Aifryz/sensor-hub/hardware/sensor-hub/v1.0/sensor-hub.pdf

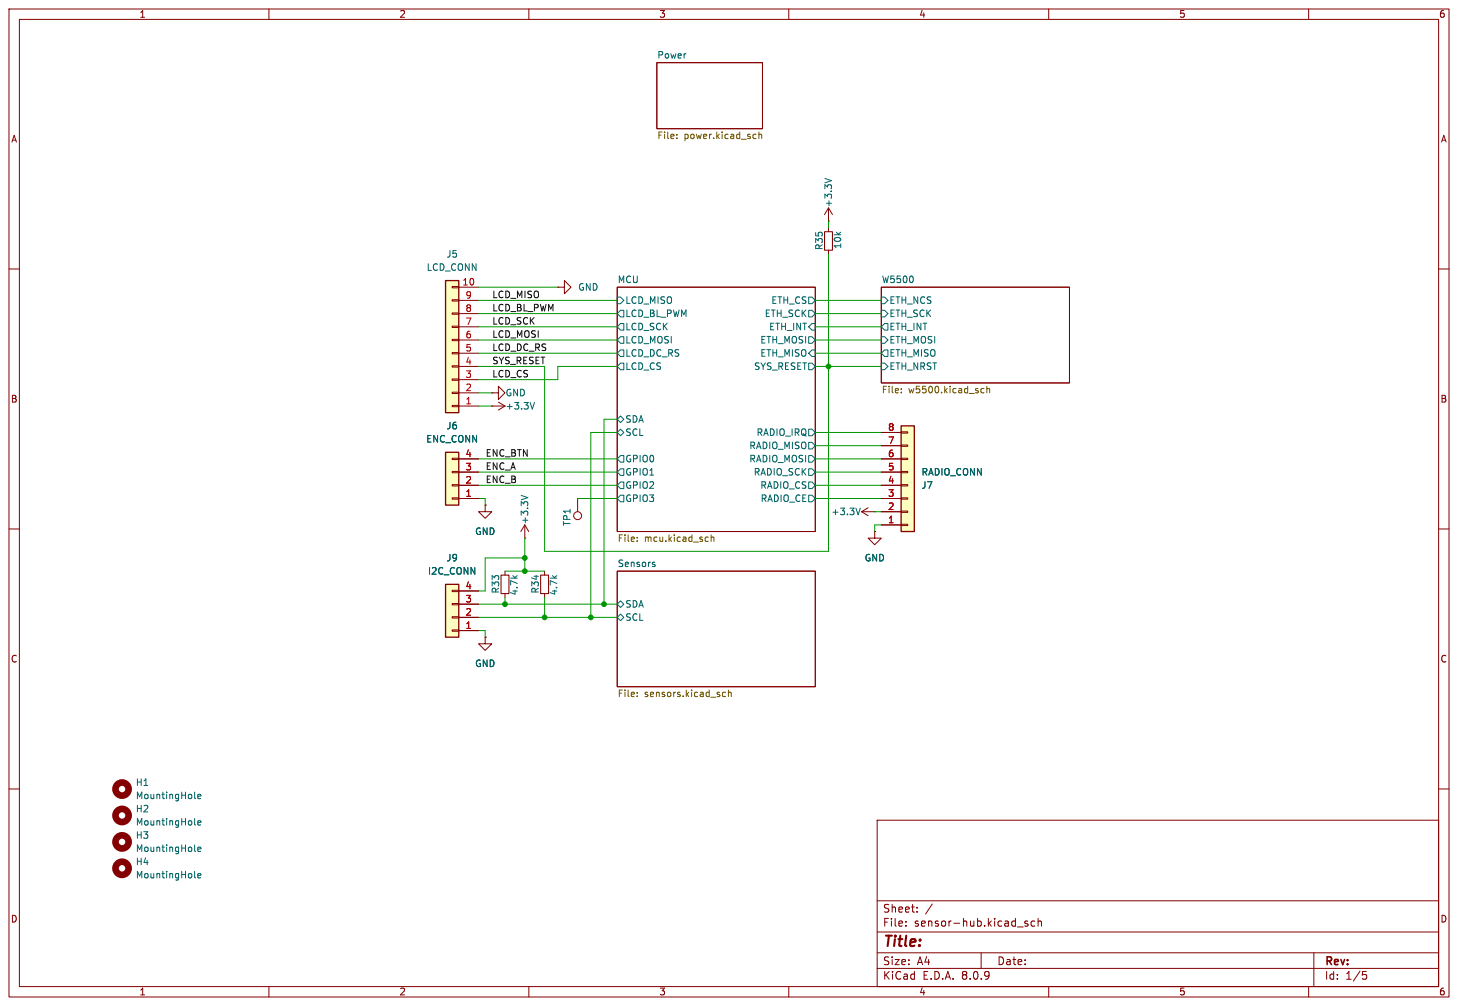
[picture p1: page 1]

Id: 1/5 Title: File: sensor-hub.kicad_sch Sheet: /

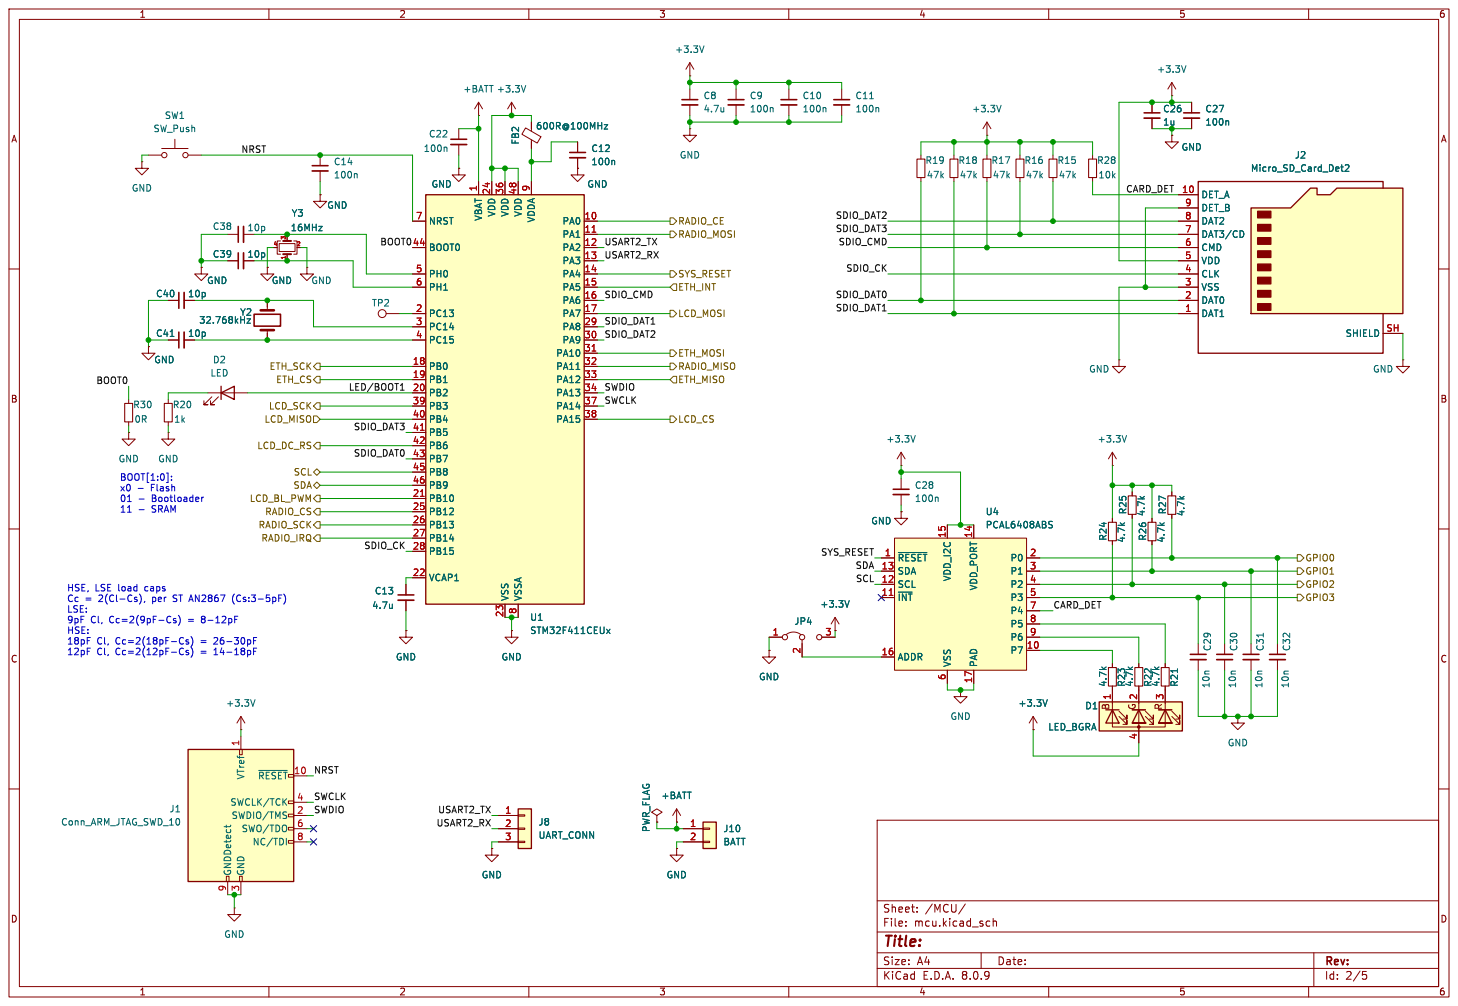
[picture p2: page 2]

1 PA0 10 PA1 11 PA2 12 PA3 13 PA4 14 PA5 15 PA6 16 PA7 17 PB0 18 PB1 19 PC13 2 PB2 20 PB10 21 VCAP1 22 VSS 23 VDD 24 PB12 25 PB13 26 PB14 27 PB15 28 PA8 29 PC14 3 PA9 30 PA10 31 PA11 32 PA12 33 PA13 34 VDD 36 PA14 37 PA15 38 PB3 39 PC15 4 PB4 40 PB5 41 PB6 42 PB7 43 BOOT0 44 PB8 45 PB9 46 VDD 48 PH0 5 PH1 6 NRST 7 VSSA

3 SWCLK/TCK 4 SWO/TDO 6 NC/TDI 8 GNDDetect 9

Id: 2/5 Title: File: mcu.kicad_sch Sheet: /MCU/

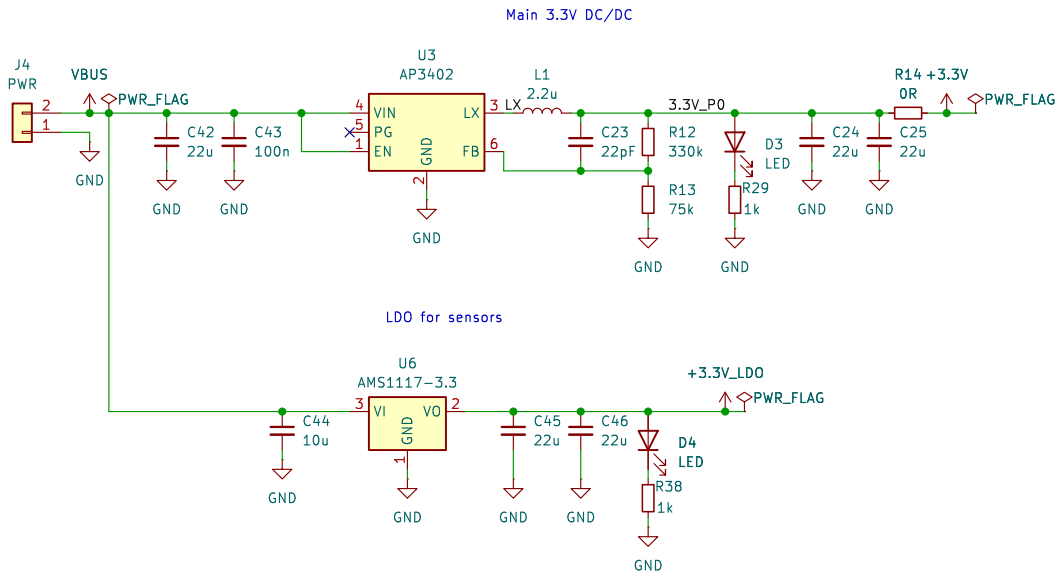
[picture p3: page 3]

LDO for sensors Main 3.3V DC/DC

Id: 3/5 Title: File: power.kicad_sch Sheet: /Power/

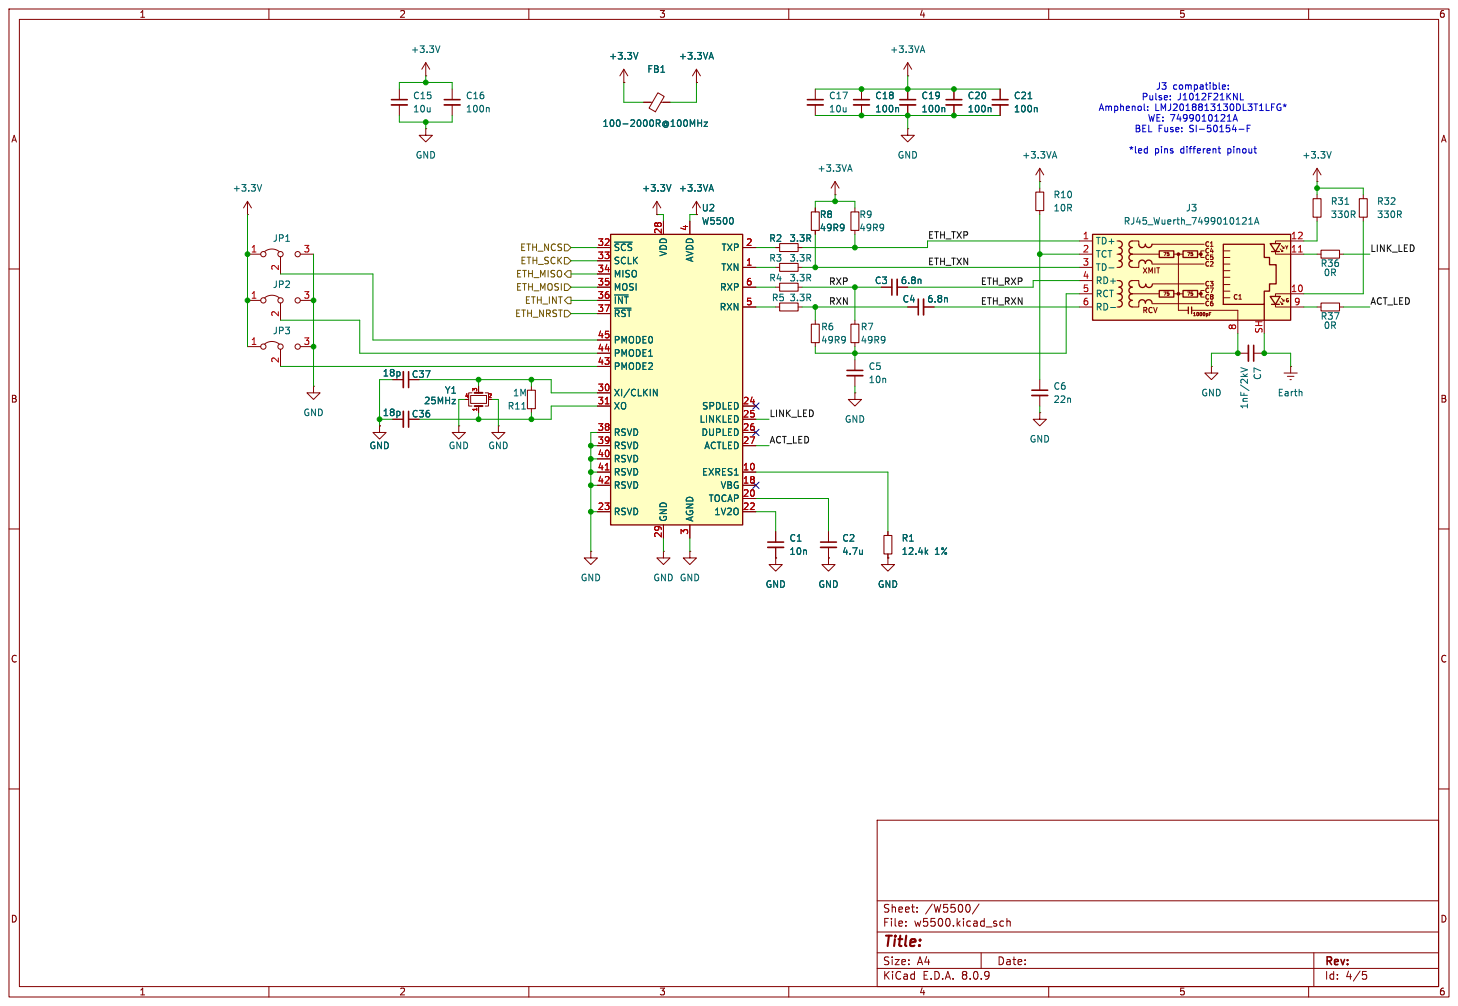
[picture p4: page 4]

J3 compatible: Pulse: J1012F21KNL Amphenol: LMJ2018813130DL3T1LFG* WE: 7499010121A

4 RSVD 40 RSVD 41 RSVD 42 PMODE2 43 PMODE1 44 PMODE0 45 RXN 5 RXP 6 U2 W5500 GND GND GND

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

3 XI/CLKIN 30 XO 31 ~{SCS} 32 SCLK 33 MISO 34 MOSI 35 ~{INT} 36 ~{RST} 37 RSVD 38 RSVD 39 AVDD

Id: 4/5 Title: File: w5500.kicad_sch Sheet: /W5500/

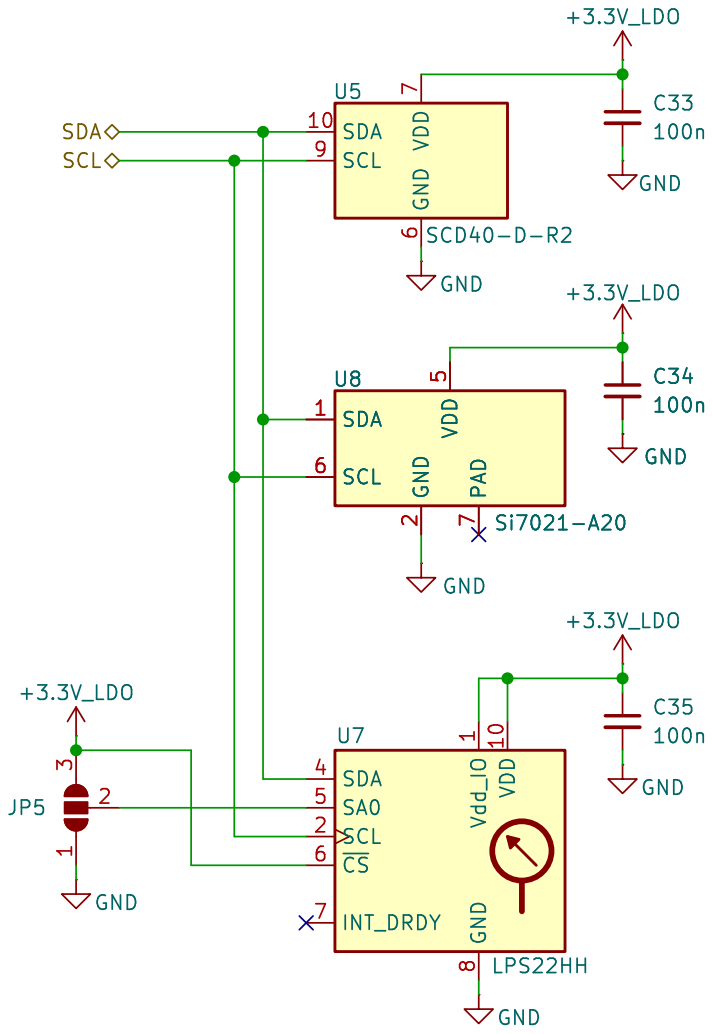
[picture p5: page 5]

Id: 5/5 Title: File: sensors.kicad_sch Sheet: /Sensors/
