Aifryz/sensor-hub/hardware/sensor-hub/sensor-hub.kicad_pcb

## KiCad design hardware/sensor-hub/sensor-hub.kicad_pcb (2025-05-18)

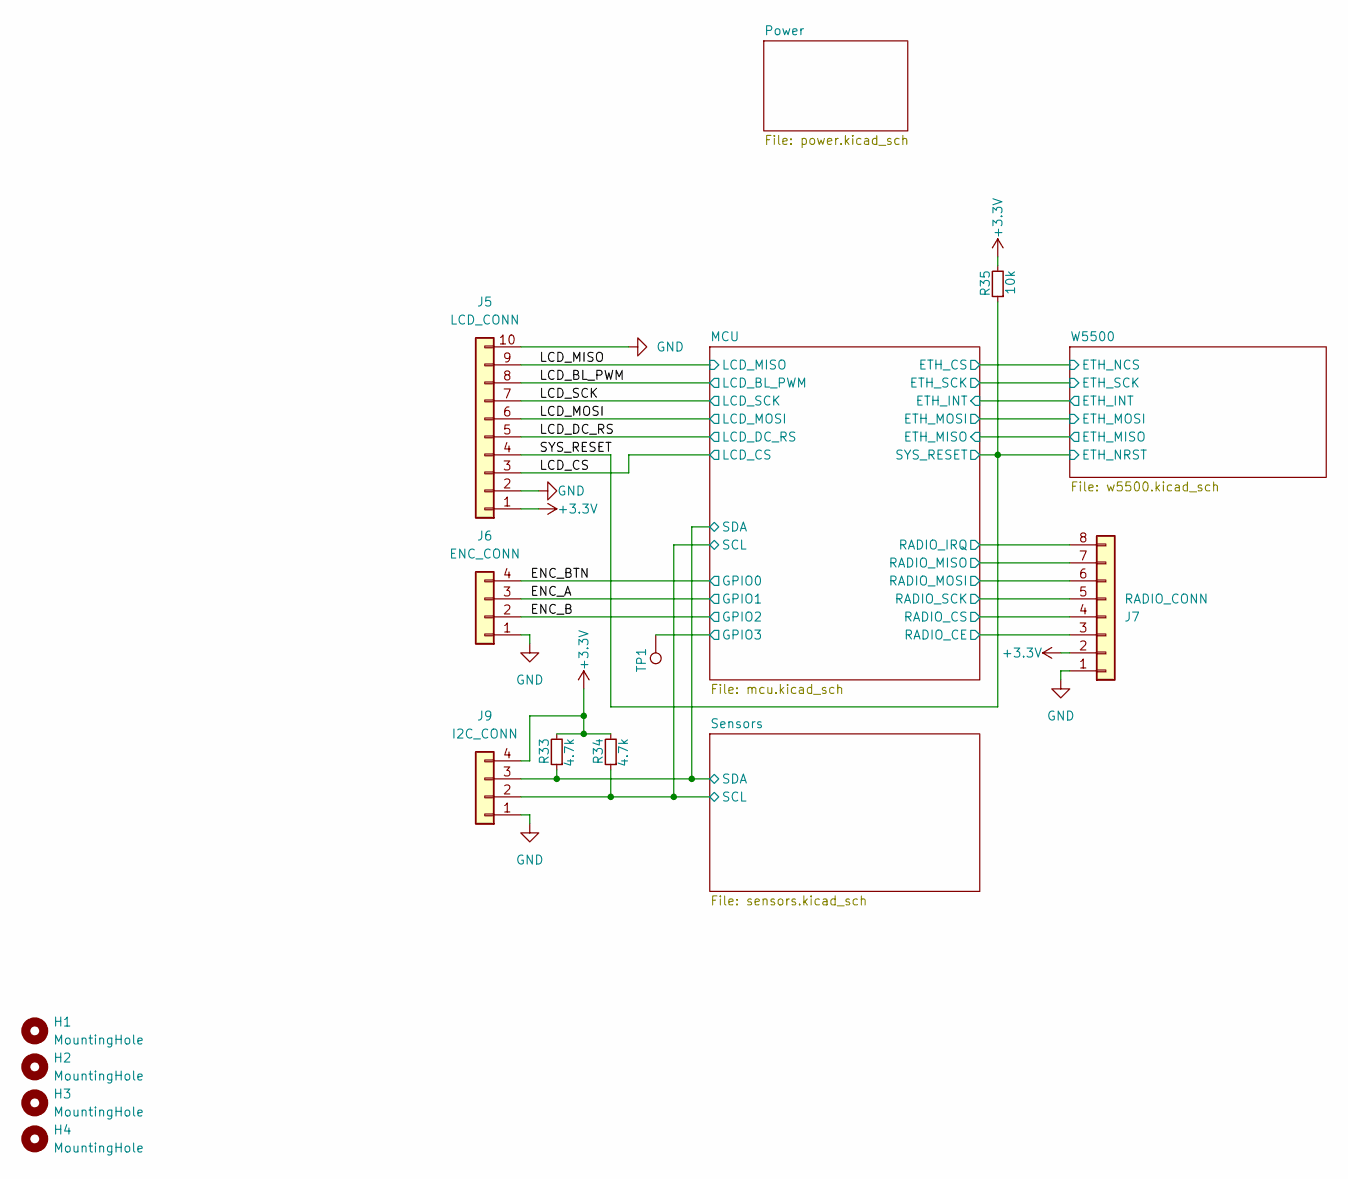
[picture p6: schematic sensor-hub.kicad_sch]

Parts:
H1, H2, H3, H4: MountingHole; MountingHole_3mm
J5: LCD_CONN; TE_Micro-MaTch_1-215079-0_2x05_P1.27mm_Vertical
J6: ENC_CONN; TE_Micro-MaTch_215079-4_2x02_P1.27mm_Vertical
J7: RADIO_CONN; TE_Micro-MaTch_215079-8_2x04_P1.27mm_Vertical
J9: I2C_CONN; PinHeader_1x04_P2.54mm_Vertical
R33, R34: 4.7k; R_0603_1608Metric
R35: 10k; R_0603_1608Metric
TP1: TestPoint; TestPoint_Pad_D1.0mm

Connections:
+3.3V: J5.1, J7.2, J9.4, R33.2, R34.2, R35.2; also elsewhere on the board
/ENC_A: J6.3; also elsewhere on the board
/ENC_B: J6.2; also elsewhere on the board
/ENC_BTN: J6.4; also elsewhere on the board
/LCD_BL_PWM: J5.8; also elsewhere on the board
/LCD_CS: J5.3; also elsewhere on the board
/LCD_DC_RS: J5.5; also elsewhere on the board
/LCD_MISO: J5.9; also elsewhere on the board
/LCD_MOSI: J5.6; also elsewhere on the board
/LCD_SCK: J5.7; also elsewhere on the board
/MCU/GPIO3: TP1.1; also elsewhere on the board
/MCU/RADIO_CE: J7.3; also elsewhere on the board
/MCU/RADIO_CS: J7.4; also elsewhere on the board
/MCU/RADIO_IRQ: J7.8; also elsewhere on the board
/MCU/RADIO_MISO: J7.7; also elsewhere on the board
/MCU/RADIO_MOSI: J7.6; also elsewhere on the board
/MCU/RADIO_SCK: J7.5; also elsewhere on the board
/MCU/SCL: J9.2, R34.1; also elsewhere on the board
/MCU/SDA: J9.3, R33.1; also elsewhere on the board
/SYS_RESET: J5.4, R35.1; also elsewhere on the board
GND: J5.2, J5.10, J6.1, J7.1, J9.1; also elsewhere on the board

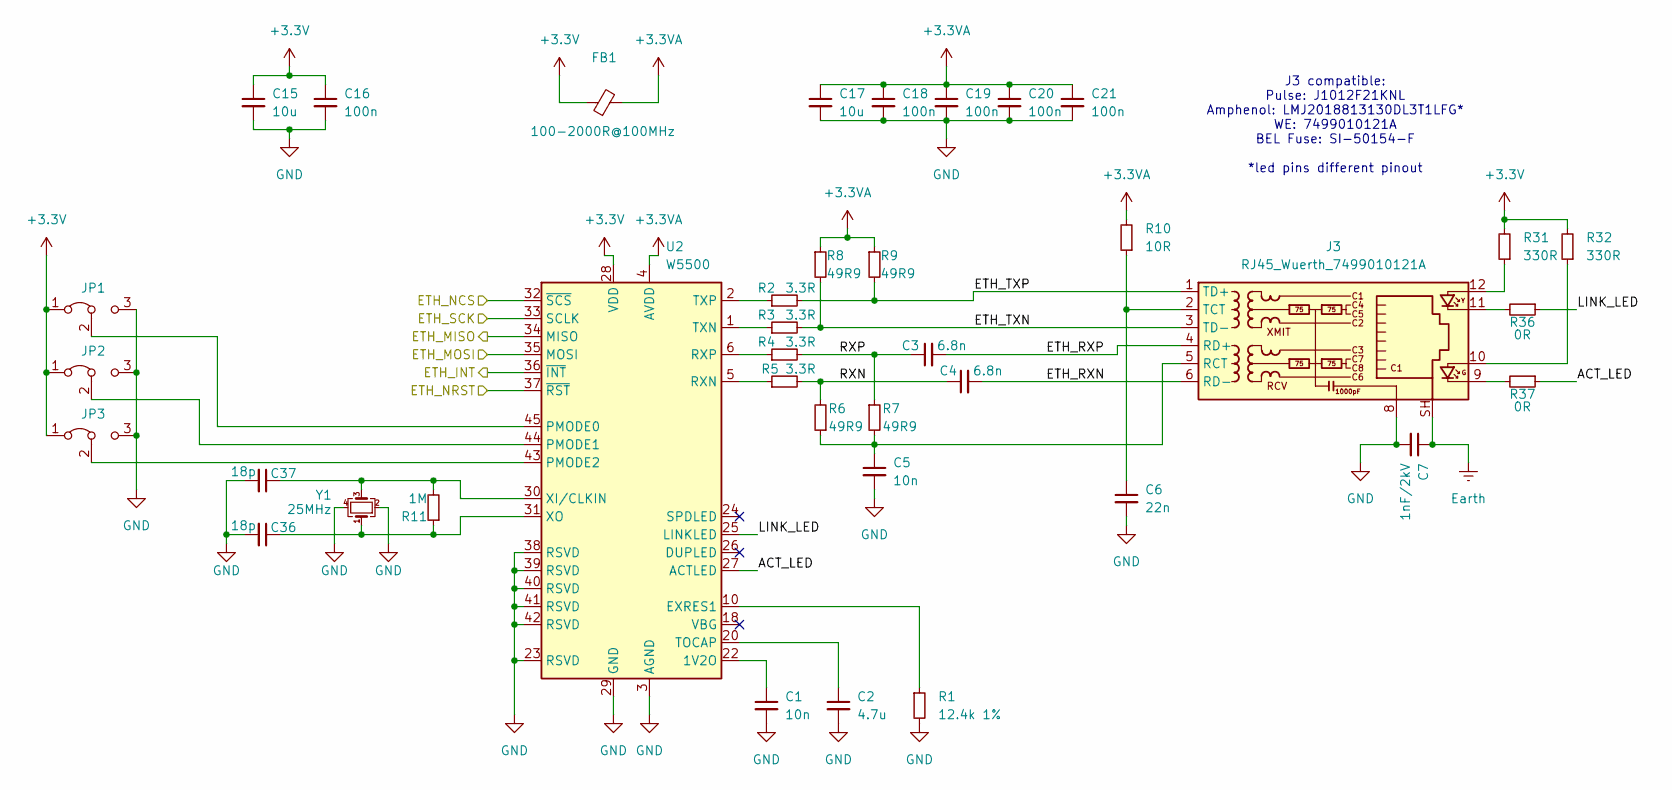
[picture p7: schematic w5500.kicad_sch]

Parts:
C1, C5: 10n; C_0603_1608Metric
C2: 4.7u; C_0603_1608Metric
C3, C4: 6.8n; C_0603_1608Metric
C6: 22n; C_0603_1608Metric
C7: 1nF/2kV; C_1206_3216Metric
C15, C17: 10u; C_0805_2012Metric
C16, C18, C19, C20, C21: 100n; C_0603_1608Metric
C36, C37: 18p; C_0603_1608Metric
FB1: 100-2000R@100MHz; L_0603_1608Metric
J3: RJ45_Wuerth_7499010121A; RJ45_Wuerth_7499010121A_Horizontal
JP1, JP2, JP3: SolderJumper-3_P1.3mm_Bridged12_RoundedPad1.0x1.5mm
R1: 12.4k 1%; R_0603_1608Metric
R2, R3, R4, R5: 3.3R; R_0603_1608Metric
R6, R7, R8, R9: 49R9; R_0603_1608Metric
R10: 10R; R_0603_1608Metric
R11: 1M; R_0603_1608Metric
R31, R32: 330R; R_0603_1608Metric
R36, R37: 0R; R_0603_1608Metric
U2: W5500; LQFP-48_7x7mm_P0.5mm
Y1: 25MHz; Crystal_SMD_SeikoEpson_TSX3225-4Pin_3.2x2.5mm

Connections:
+3.3V: C15.1, C16.1, FB1.1, JP1.1 (A), JP2.1 (A), JP3.1 (A), R31.2, R32.2, U2.28 (VDD); also elsewhere on the board
+3.3VA: C17.1, C18.1, C19.1, C20.1, C21.1, FB1.2, R8.1, R9.1, R10.2, U2.4 (AVDD), U2.8 (AVDD), U2.11 (AVDD), U2.15 (AVDD), U2.17 (AVDD), U2.21 (AVDD)
/MCU/ETH_CS: U2.32 (~SCS); also elsewhere on the board
/MCU/ETH_INT: U2.36 (~INT); also elsewhere on the board
/MCU/ETH_MISO: U2.34 (MISO); also elsewhere on the board
/MCU/ETH_MOSI: U2.35 (MOSI); also elsewhere on the board
/MCU/ETH_SCK: U2.33 (SCLK); also elsewhere on the board
/SYS_RESET: U2.37 (~RST); also elsewhere on the board
/W5500/ACT_LED: R37.1, U2.27 (ACTLED)
/W5500/ETH_RXN: C4.2, J3.6 (RD-)
/W5500/ETH_RXP: C3.2, J3.4 (RD+)
/W5500/ETH_TXN: J3.3 (TD-), R3.2, R8.2
/W5500/ETH_TXP: J3.1 (TD+), R2.2, R9.2
/W5500/LINK_LED: R36.1, U2.25 (LINKLED)
/W5500/RXN: C4.1, R5.2, R6.2
/W5500/RXP: C3.1, R4.2, R7.1
Earth: C7.1, J3.SH
GND: C1.2, C2.2, C5.2, C6.2, C7.2, C15.2, C16.2, C17.2, C18.2, C19.2, C20.2, C21.2, C36.2, C37.2, J3.8, JP1.3 (B), JP2.3 (B), JP3.3 (B), R1.2, U2.3 (AGND), U2.9 (AGND), U2.14 (AGND), U2.16 (AGND), U2.19 (AGND), U2.23 (RSVD), U2.29 (GND), U2.38 (RSVD), U2.39 (RSVD), U2.40 (RSVD), U2.41 (RSVD), U2.42 (RSVD), U2.48 (AGND), Y1.2, Y1.4; also elsewhere on the board
unnamed: J3.9, R37.2
unnamed: J3.10, R32.1
unnamed: J3.11, R36.2
unnamed: J3.12, R31.1
unnamed: C5.1, J3.5 (RCT), R6.1, R7.2
unnamed: C6.1, J3.2 (TCT), R10.1
unnamed: JP1.2 (C), U2.45 (PMODE0)
unnamed: JP2.2 (C), U2.44 (PMODE1)
unnamed: JP3.2 (C), U2.43 (PMODE2)
unnamed: C1.1, U2.22 (1V2O)
unnamed: R1.1, U2.10 (EXRES1)
unnamed: R5.1, U2.5 (RXN)
unnamed: R4.1, U2.6 (RXP)
unnamed: C2.1, U2.20 (TOCAP)
unnamed: R3.1, U2.1 (TXN)
unnamed: R2.1, U2.2 (TXP)
unnamed: C37.1, R11.2, U2.30 (XI/CLKIN), Y1.3
unnamed: C36.1, R11.1, U2.31 (XO), Y1.1

Notes on the sheet:
J3 compatible: Pulse: J1012F21KNL Amphenol: LMJ2018813130DL3T1LFG* WE: 7499010121A BEL Fuse: SI-50154-F *led pins different pinout

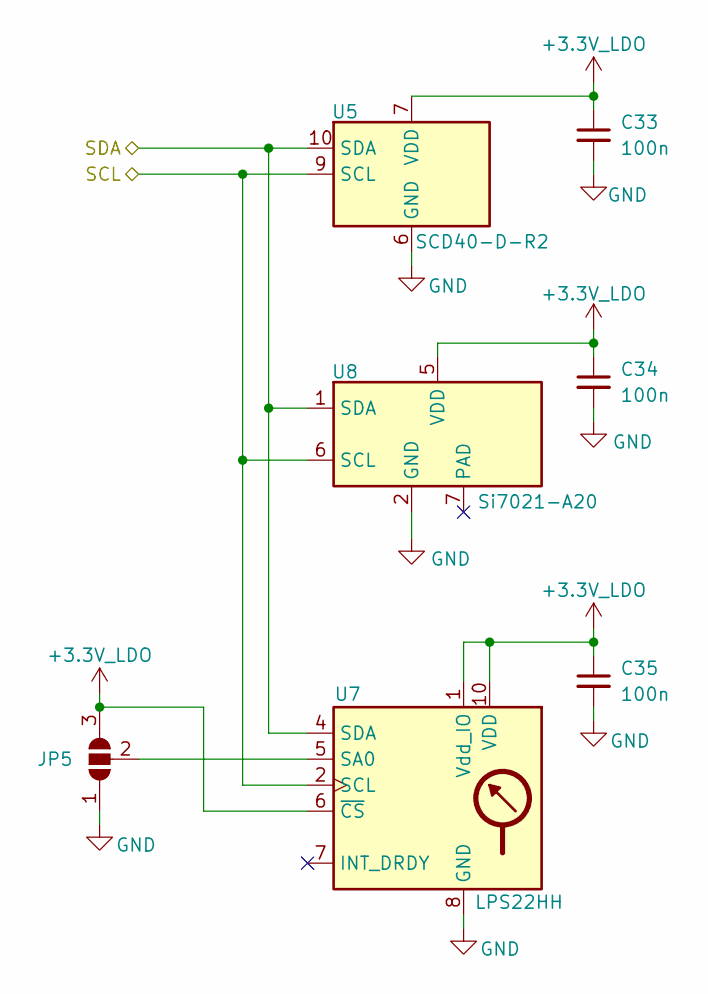
[picture p8: schematic sensors.kicad_sch]

Parts:
C33, C34, C35: 100n; C_0603_1608Metric
JP5: SolderJumper_3_Open; SolderJumper-3_P1.3mm_Open_RoundedPad1.0x1.5mm
U5: SCD40-D-R2; Sensirion_SCD4x-1EP_10.1x10.1mm_P1.25mm_EP4.8x4.8mm
U7: LPS22HH; ST_HLGA-10_2x2mm_P0.5mm_LayoutBorder3x2y
U8: Si7021-A20; DFN-6-1EP_3x3mm_P1mm_EP1.5x2.4mm

Connections:
+3.3V_LDO: C33.1, C34.1, C35.1, JP5.3 (B), U5.7 (VDD), U5.19 (VDD), U7.1 (Vdd_IO), U7.6 (~CS), U7.10 (VDD), U8.5 (VDD); also elsewhere on the board
/MCU/SCL: U5.9 (SCL), U7.2 (SCL), U8.6 (SCL); also elsewhere on the board
/MCU/SDA: U5.10 (SDA), U7.4 (SDA), U8.1 (SDA); also elsewhere on the board
GND: C33.2, C34.2, C35.2, JP5.1 (A), U5.6 (GND), U5.20 (GND), U5.21 (GND), U7.3 (GND), U7.8 (GND), U7.9 (GND), U8.2 (GND); also elsewhere on the board
unnamed: JP5.2 (C), U7.5 (SA0)

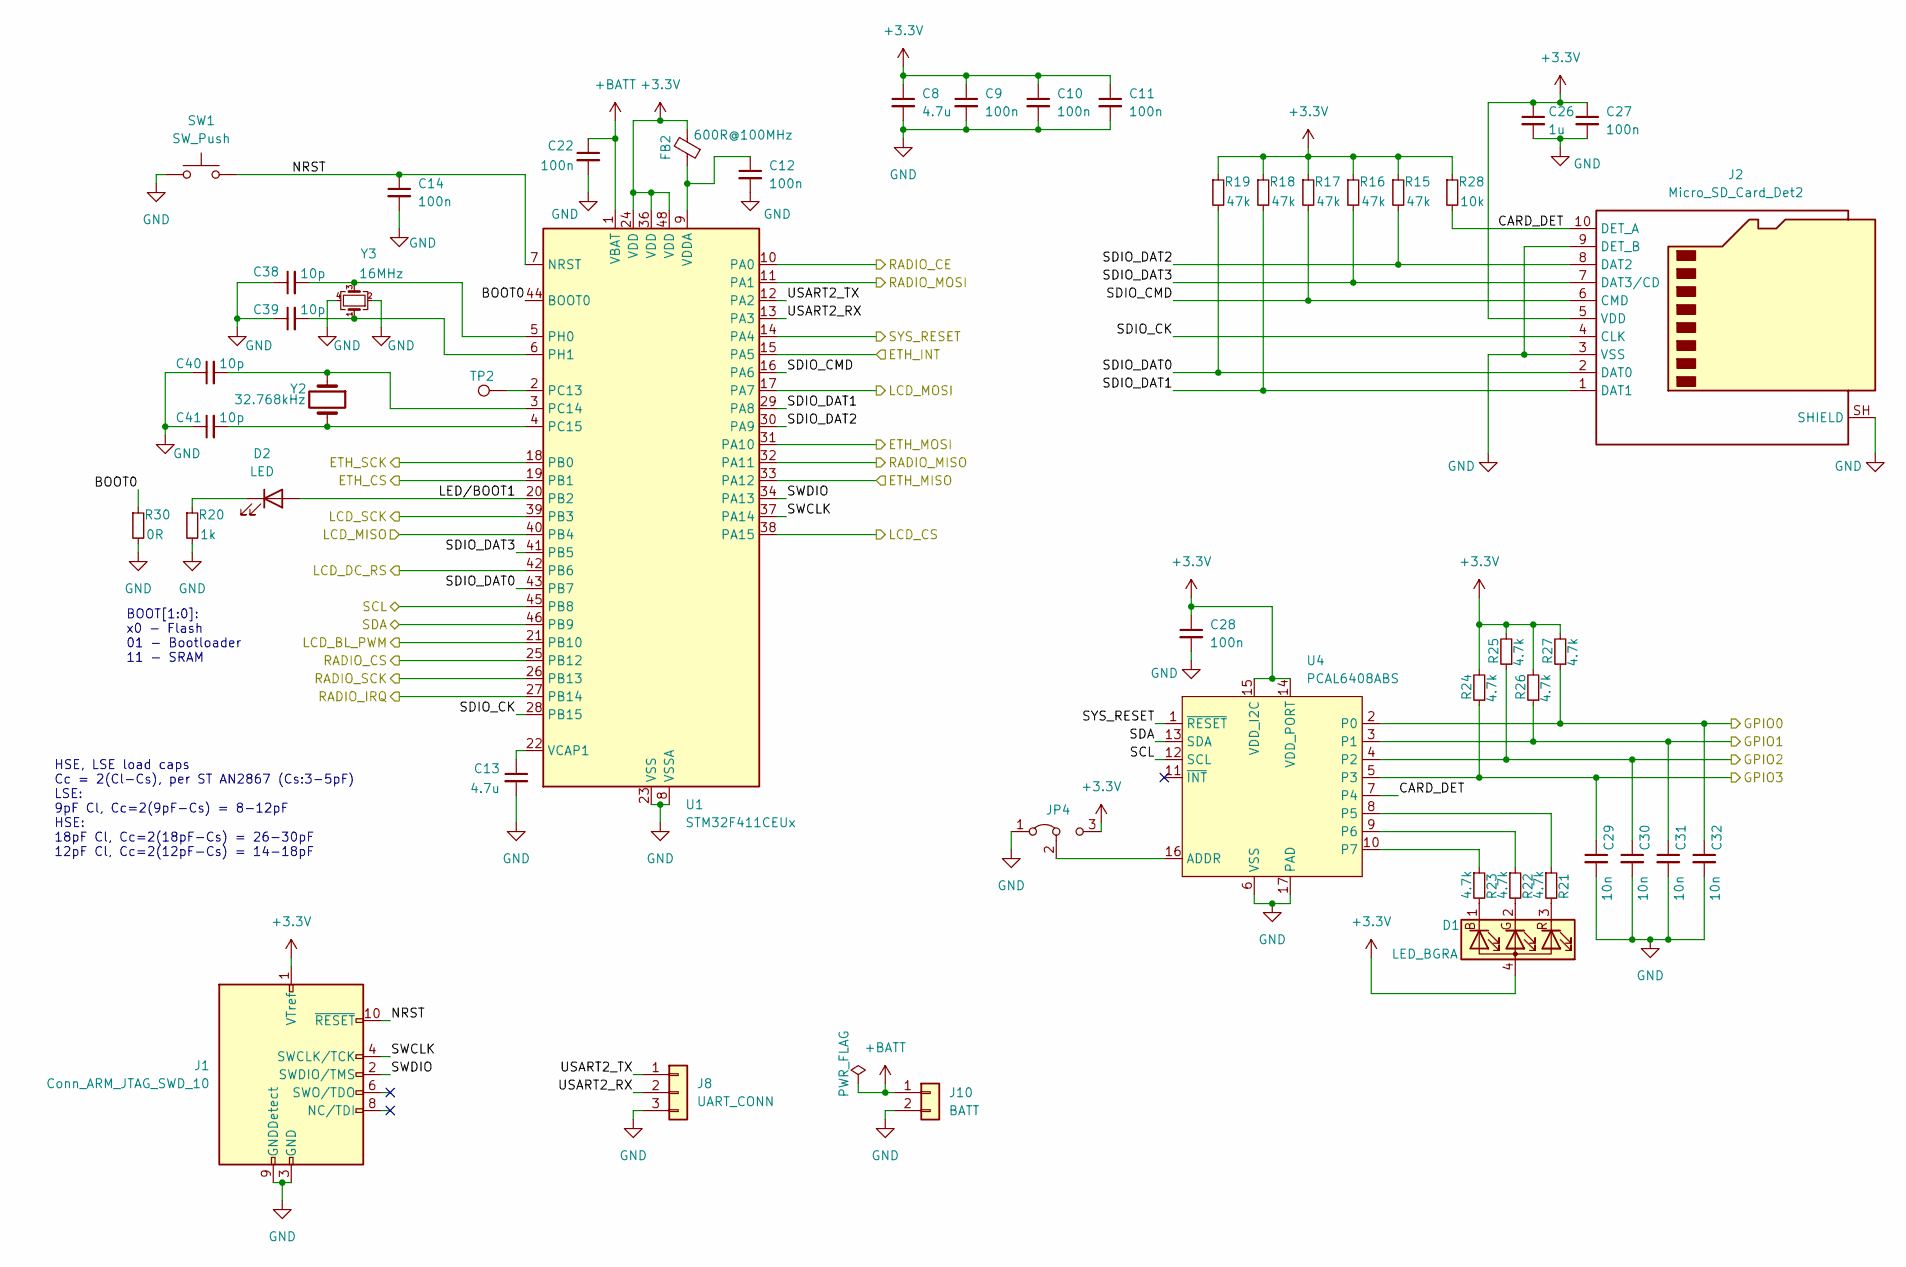
[picture p9: schematic mcu.kicad_sch]

Parts:
C8, C13: 4.7u; C_0603_1608Metric
C9, C10, C11, C12, C14, C22, C27, C28: 100n; C_0603_1608Metric
C26: 1u; C_0603_1608Metric
C29, C30, C31, C32: 10n; C_0603_1608Metric
C38, C39, C40, C41: 10p; C_0603_1608Metric
D1: LED_BGRA; LED_Cree-PLCC4_3.2x2.8mm_CCW
D2: LED; LED_0603_1608Metric
FB2: 600R@100MHz; L_0603_1608Metric
J1: Conn_ARM_JTAG_SWD_10; PinHeader_2x05_P1.27mm_Vertical_SMD
J2: Micro_SD_Card_Det2; MicroSD_Det2
J8: UART_CONN; PinHeader_1x03_P2.54mm_Vertical
J10: BATT; BatteryHolder_MYOUNG_BS-07-A1BJ001_CR2032
JP4: SolderJumper-3_P1.3mm_Bridged12_RoundedPad1.0x1.5mm
R15, R16, R17, R18, R19: 47k; R_0603_1608Metric
R20: 1k; R_0603_1608Metric
R21, R22, R23, R24, R25, R26, R27: 4.7k; R_0603_1608Metric
R28: 10k; R_0603_1608Metric
R30: 0R; R_0603_1608Metric
SW1: SW_Push; SW_SPST_CK_RS282G05A3
TP2: TestPoint; TestPoint_Pad_D1.0mm
U1: STM32F411CEUx; QFN-48-1EP_7x7mm_P0.5mm_EP5.6x5.6mm
U4: PCAL6408ABS; QFN-16-1EP_3x3mm_P0.5mm_EP1.45x1.45mm
Y2: 32.768kHz; Crystal_SMD_3215-2Pin_3.2x1.5mm
Y3: 16MHz; Crystal_SMD_SeikoEpson_TSX3225-4Pin_3.2x2.5mm

Connections:
+3.3V: C8.1, C9.1, C10.1, C11.1, C26.1, C27.1, C28.1, D1.4 (A), FB2.2, J1.1 (VTref), J2.5 (VDD), JP4.3 (B), R15.1, R16.1, R17.1, R18.1, R19.1, R24.2, R25.2, R26.2, R27.2, R28.1, U1.24 (VDD), U1.36 (VDD), U1.48 (VDD), U4.14 (VDD_PORT), U4.15 (VDD_I2C); also elsewhere on the board
+BATT: C22.1, J10.1, U1.1 (VBAT)
/ENC_A: C31.1, R26.1, U4.3 (P1); also elsewhere on the board
/ENC_B: C30.1, R25.1, U4.4 (P2); also elsewhere on the board
/ENC_BTN: C32.1, R27.1, U4.2 (P0); also elsewhere on the board
/LCD_BL_PWM: U1.21 (PB10); also elsewhere on the board
/LCD_CS: U1.38 (PA15); also elsewhere on the board
/LCD_DC_RS: U1.42 (PB6); also elsewhere on the board
/LCD_MISO: U1.40 (PB4); also elsewhere on the board
/LCD_MOSI: U1.17 (PA7); also elsewhere on the board
/LCD_SCK: U1.39 (PB3); also elsewhere on the board
/MCU/BOOT0: R30.1, U1.44 (BOOT0)
/MCU/CARD_DET: J2.10 (DET_A), R28.2, U4.7 (P4)
/MCU/ETH_CS: U1.19 (PB1); also elsewhere on the board
/MCU/ETH_INT: U1.15 (PA5); also elsewhere on the board
/MCU/ETH_MISO: U1.33 (PA12); also elsewhere on the board
/MCU/ETH_MOSI: U1.31 (PA10); also elsewhere on the board
/MCU/ETH_SCK: U1.18 (PB0); also elsewhere on the board
/MCU/GPIO3: C29.1, R24.1, U4.5 (P3); also elsewhere on the board
/MCU/LED/BOOT1: D2.2 (A), U1.20 (PB2)
/MCU/NRST: C14.1, J1.10 (~RESET), SW1.2, U1.7 (NRST)
/MCU/RADIO_CE: U1.10 (PA0); also elsewhere on the board
/MCU/RADIO_CS: U1.25 (PB12); also elsewhere on the board
/MCU/RADIO_IRQ: U1.27 (PB14); also elsewhere on the board
/MCU/RADIO_MISO: U1.32 (PA11); also elsewhere on the board
/MCU/RADIO_MOSI: U1.11 (PA1); also elsewhere on the board
/MCU/RADIO_SCK: U1.26 (PB13); also elsewhere on the board
/MCU/SCL: U1.45 (PB8), U4.12 (SCL); also elsewhere on the board
/MCU/SDA: U1.46 (PB9), U4.13 (SDA); also elsewhere on the board
/MCU/SDIO_CK: J2.4 (CLK), U1.28 (PB15)
/MCU/SDIO_CMD: J2.6 (CMD), R17.2, U1.16 (PA6)
/MCU/SDIO_DAT0: J2.2 (DAT0), R19.2, U1.43 (PB7)
/MCU/SDIO_DAT1: J2.1 (DAT1), R18.2, U1.29 (PA8)
/MCU/SDIO_DAT2: J2.8 (DAT2), R15.2, U1.30 (PA9)
/MCU/SDIO_DAT3: J2.7 (DAT3/CD), R16.2, U1.41 (PB5)
/MCU/SWCLK: J1.4 (SWCLK/TCK), U1.37 (PA14)
/MCU/SWDIO: J1.2 (SWDIO/TMS), U1.34 (PA13)
/MCU/USART2_RX: J8.2, U1.13 (PA3)
/MCU/USART2_TX: J8.1, U1.12 (PA2)
/SYS_RESET: U1.14 (PA4), U4.1 (~RESET); also elsewhere on the board
GND: C8.2, C9.2, C10.2, C11.2, C12.2, C13.2, C14.2, C22.2, C26.2, C27.2, C28.2, C29.2, C30.2, C31.2, C32.2, C38.1, C39.1, C40.1, C41.1, J1.3 (GND), J1.5 (GND), J1.9 (GNDDetect), J2.3 (VSS), J2.9 (DET_B), J2.SH (SHIELD), J8.3, J10.2, JP4.1 (A), R20.2, R30.2, SW1.1, U1.8 (VSSA), U1.23 (VSS), U1.35 (VSS), U1.47 (VSS), U1.49 (VSS), U4.6 (VSS), U4.17 (PAD), Y3.2, Y3.4; also elsewhere on the board
unnamed: D1.1 (BK), R23.2
unnamed: D1.2 (GK), R22.2
unnamed: D1.3 (RK), R21.2
unnamed: D2.1 (K), R20.1
unnamed: JP4.2 (C), U4.16 (ADDR)
unnamed: TP2.1, U1.2 (PC13)
unnamed: C40.2, U1.3 (PC14), Y2.1
unnamed: C41.2, U1.4 (PC15), Y2.2
unnamed: C38.2, U1.5 (PH0), Y3.3
unnamed: C39.2, U1.6 (PH1), Y3.1
unnamed: C13.1, U1.22 (VCAP1)
unnamed: C12.1, FB2.1, U1.9 (VDDA)
unnamed: R21.1, U4.8 (P5)
unnamed: R22.1, U4.9 (P6)
unnamed: R23.1, U4.10 (P7)

Notes on the sheet:
BOOT[1:0]: x0 - Flash 01 - Bootloader 11 - SRAM
HSE, LSE load caps Cc = 2(Cl-Cs), per ST AN2867 (Cs:3-5pF) LSE: 9pF Cl, Cc=2(9pF-Cs) = 8-12pF HSE: 18pF Cl, Cc=2(18pF-Cs) = 26-30pF 12pF Cl, Cc=2(12pF-Cs) = 14-18pF

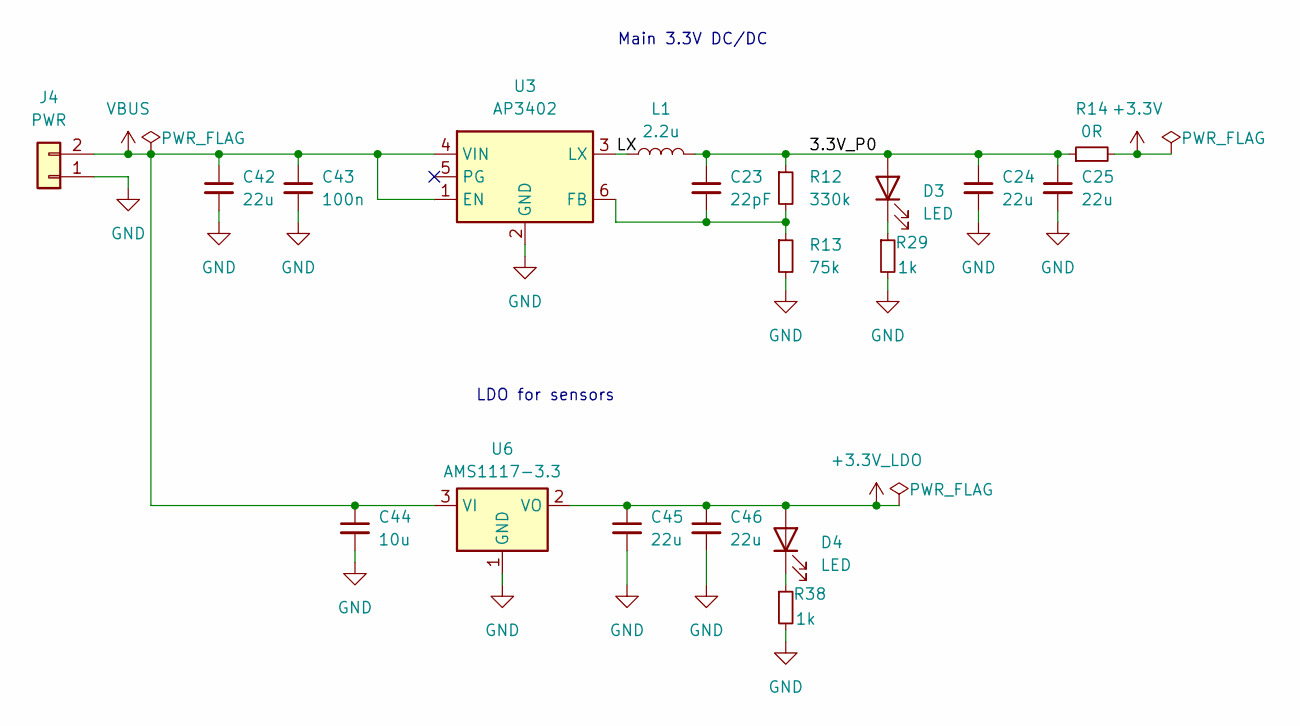
[picture p10: schematic power.kicad_sch]

Parts:
C23: 22pF; C_0603_1608Metric
C24, C25, C42, C45, C46: 22u; C_0805_2012Metric
C43: 100n; C_0603_1608Metric
C44: 10u; C_0805_2012Metric
D3, D4: LED; LED_0603_1608Metric
J4: PWR; PinHeader_1x02_P2.54mm_Vertical
L1: 2.2u; L_APV_ANR5045
R12: 330k; R_0603_1608Metric
R13: 75k; R_0603_1608Metric
R14: 0R; R_0603_1608Metric
R29, R38: 1k; R_0603_1608Metric
U3: AP3402; TSOT-23-6
U6: AMS1117-3.3; SOT-223-3_TabPin2

Connections:
+3.3V: R14.2; also elsewhere on the board
+3.3V_LDO: C45.1, C46.1, D4.2 (A), U6.2 (VO); also elsewhere on the board
/Power/3.3V_P0: C23.1, C24.1, C25.1, D3.2 (A), L1.2, R12.1, R14.1
/Power/LX: L1.1, U3.3 (LX)
GND: C24.2, C25.2, C42.2, C43.2, C44.2, C45.2, C46.2, J4.1, R13.2, R29.2, R38.2, U3.2 (GND), U6.1 (GND); also elsewhere on the board
unnamed: D3.1 (K), R29.1
unnamed: D4.1 (K), R38.1
unnamed: C23.2, R12.2, R13.1, U3.6 (FB)
VBUS: C42.1, C43.1, C44.1, J4.2, U3.1 (EN), U3.4 (VIN), U6.3 (VI)

Notes on the sheet:
LDO for sensors
Main 3.3V DC/DC

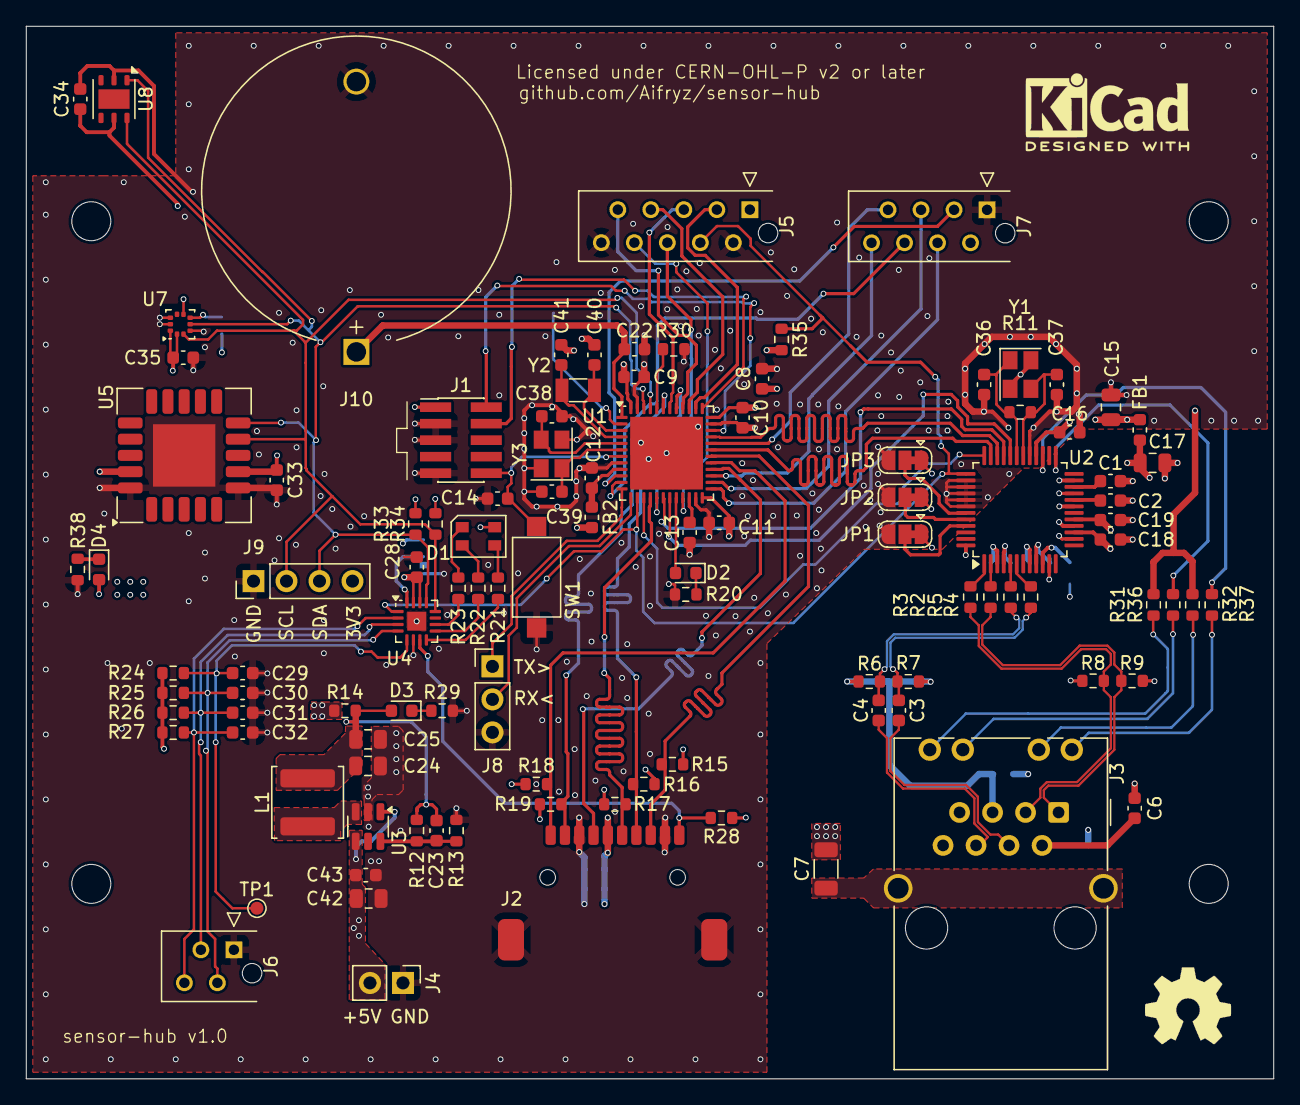
[picture p11: board sensor-hub.kicad_pcb from above]

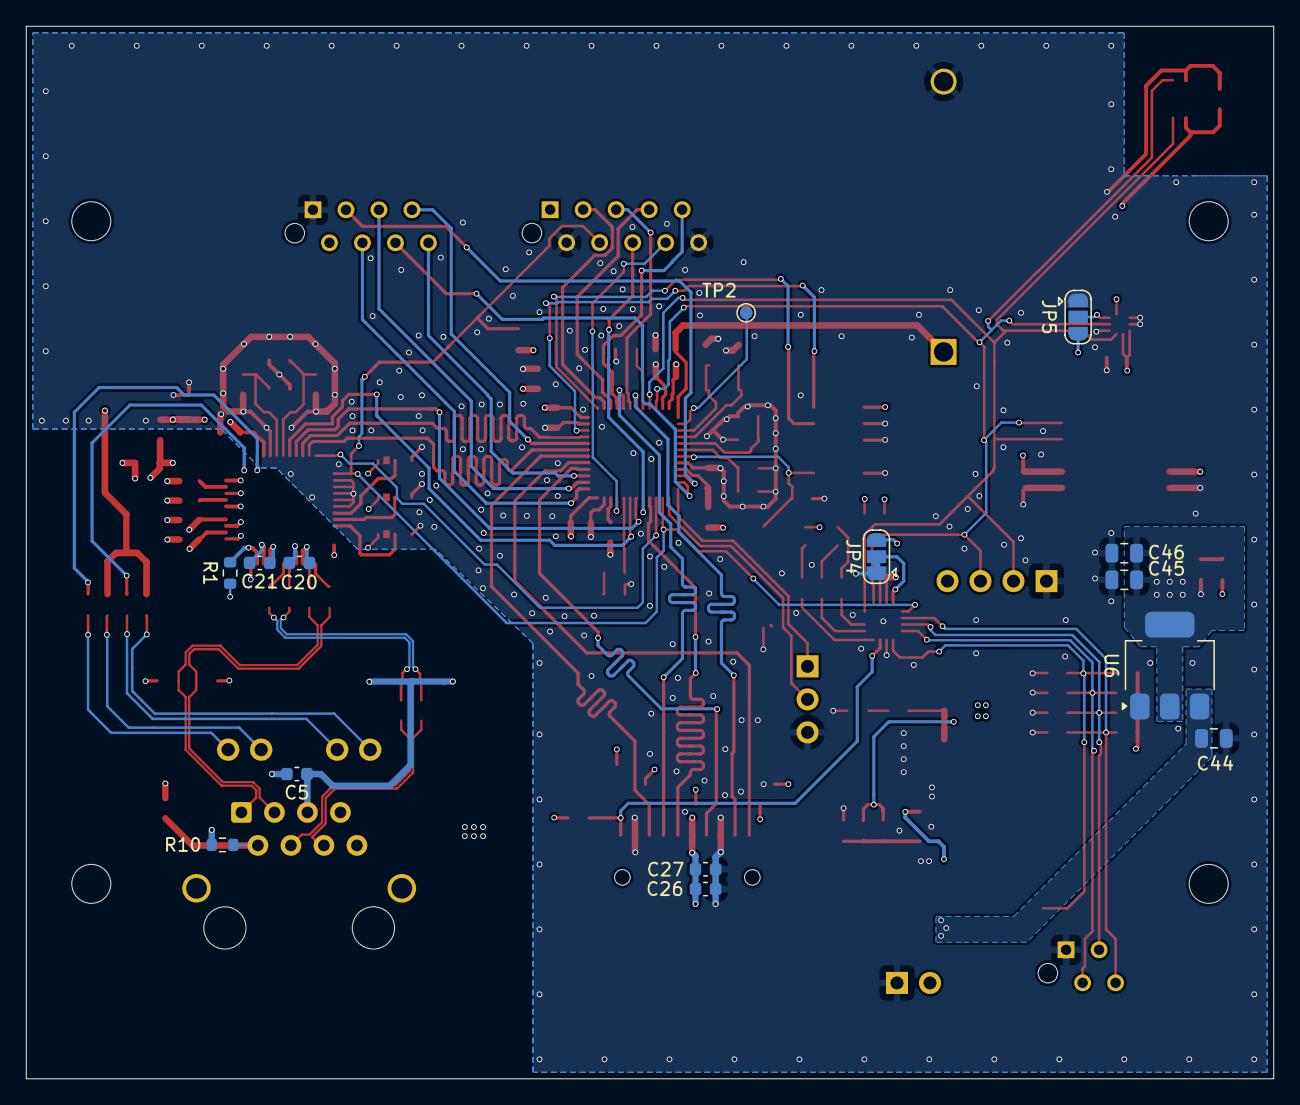
[picture p12: board sensor-hub.kicad_pcb from below]

Board: 4 copper layers, 96.0 x 81.0 mm, 124 parts (14 on the bottom side), 92 nets.
