Aifryz/sensor-hub/firmware/stm32/stm32.ioc

Mcu.UserName=STM32F411CEUx
PA0-WKUP.GPIO_Label=RADIO_CE
PA0-WKUP.Signal=GPIO_Output
PA1.GPIO_Label=RADIO_MOSI
PA1.Signal=SPI4_MOSI
PA10.GPIO_Label=ETH_MOSI
PA10.Signal=SPI5_MOSI
PA11.GPIO_Label=RADIO_MISO
PA11.Signal=SPI4_MISO
PA12.GPIO_Label=ETH_MISO
PA12.Signal=SPI5_MISO
PA13.Signal=SYS_JTMS-SWDIO
PA14.Signal=SYS_JTCK-SWCLK
PA15.GPIO_Label=LCD_CS
PA15.Signal=GPIO_Output
PA2.Signal=USART2_TX
PA3.Signal=USART2_RX
PA4.GPIO_Label=SYS_RESET
PA4.Signal=GPIO_Output
PA5.GPIO_Label=ETH_INT
PA5.Signal=GPXTI5
PA6.Signal=SDIO_CMD
PA7.GPIO_Label=LCD_MOSI
PA7.Signal=SPI1_MOSI
PA8.Signal=SDIO_D1
PA9.Signal=SDIO_D2
PB0.GPIO_Label=ETH_SCK
PB0.Signal=SPI5_SCK
PB1.GPIO_Label=ETH_CS
PB1.Signal=GPIO_Output
PB10.GPIO_Label=LCD_BL_PWM
PB10.Signal=S_TIM2_CH3
PB12.GPIO_Label=RADIO_CS
PB12.Signal=GPIO_Output
PB13.GPIO_Label=RADIO_SCK
PB13.Signal=SPI4_SCK
PB14.GPIO_Label=RADIO_IRQ
PB14.Signal=GPXTI14
PB15.Signal=SDIO_CK
PB2.GPIO_Label=SYS_LED
PB2.Signal=GPIO_Output
PB3.GPIO_Label=LCD_SCK
PB3.Signal=SPI1_SCK
PB4.GPIO_Label=LCD_MISO
PB4.Signal=SPI1_MISO
PB5.Signal=SDIO_D3
PB6.GPIO_Label=LCD_DC_RS
PB6.Signal=GPIO_Output
PB7.Signal=SDIO_D0
PB8.Signal=I2C1_SCL
PB9.Signal=I2C1_SDA
PC14-OSC32_IN.Signal=RCC_OSC32_IN
PC15-OSC32_OUT.Signal=RCC_OSC32_OUT
