Aifryz/sensor-hub/firmware/stm32/Core/Inc/main.h

#define RADIO_CE_Pin GPIO_PIN_0
#define RADIO_CE_GPIO_Port GPIOA
#define RADIO_MOSI_Pin GPIO_PIN_1
#define RADIO_MOSI_GPIO_Port GPIOA
#define SYS_RESET_Pin GPIO_PIN_4
#define SYS_RESET_GPIO_Port GPIOA
#define ETH_INT_Pin GPIO_PIN_5
#define ETH_INT_GPIO_Port GPIOA
#define LCD_MOSI_Pin GPIO_PIN_7
#define LCD_MOSI_GPIO_Port GPIOA
#define ETH_SCK_Pin GPIO_PIN_0
#define ETH_SCK_GPIO_Port GPIOB
#define ETH_CS_Pin GPIO_PIN_1
#define ETH_CS_GPIO_Port GPIOB
#define SYS_LED_Pin GPIO_PIN_2
#define SYS_LED_GPIO_Port GPIOB
#define LCD_BL_PWM_Pin GPIO_PIN_10
#define LCD_BL_PWM_GPIO_Port GPIOB
#define RADIO_CS_Pin GPIO_PIN_12
#define RADIO_CS_GPIO_Port GPIOB
#define RADIO_SCK_Pin GPIO_PIN_13
#define RADIO_SCK_GPIO_Port GPIOB
#define RADIO_IRQ_Pin GPIO_PIN_14
#define RADIO_IRQ_GPIO_Port GPIOB
#define ETH_MOSI_Pin GPIO_PIN_10
#define ETH_MOSI_GPIO_Port GPIOA
#define RADIO_MISO_Pin GPIO_PIN_11
#define RADIO_MISO_GPIO_Port GPIOA
#define ETH_MISO_Pin GPIO_PIN_12
#define ETH_MISO_GPIO_Port GPIOA
#define LCD_CS_Pin GPIO_PIN_15
#define LCD_CS_GPIO_Port GPIOA
#define LCD_SCK_Pin GPIO_PIN_3
#define LCD_SCK_GPIO_Port GPIOB
#define LCD_MISO_Pin GPIO_PIN_4
#define LCD_MISO_GPIO_Port GPIOB
#define LCD_DC_RS_Pin GPIO_PIN_6
#define LCD_DC_RS_GPIO_Port GPIOB
