Aifryz/sensor-hub/(commit log)

2022-12-04 Initial config, add stm32 project
2023-02-28 Fix config, add newlib threadsafe, add logging stub
    [app.cpp, log.hpp, newlib_lock_glue.c, stm32_lock.h]
2023-04-10 Add board gpio
2025-03-08 Add initial sensor-hub schematic
    [mcu.kicad_sch, power.kicad_sch, sensor-hub.kicad_pcb, sensor-hub.kicad_sch, w5500.kicad_sch]
2025-03-08 Add MicroSD card footprint
2025-03-15 Add sensors, connectors
    [mcu.kicad_sch, sensor-hub.kicad_sch, sensors.kicad_sch, w5500.kicad_sch]
2025-03-27 Change crystal packages, assign footprints
    [mcu.kicad_sch, power.kicad_sch, sensor-hub.kicad_sch, sensors.kicad_sch, w5500.kicad_sch]
2025-04-19 Assign remaining footprints, change HT sensor
    [mcu.kicad_sch, power.kicad_sch, sensor-hub.kicad_sch, sensors.kicad_sch, w5500.kicad_sch]
2025-04-29 Start layout
    [mcu.kicad_sch, power.kicad_sch, sensor-hub.kicad_pcb, sensor-hub.kicad_sch, w5500.kicad_sch]
2025-05-05 Restart layout with proper constraints
    [sensor-hub.kicad_pcb]
2025-05-10 Core layout done
    [mcu.kicad_sch, power.kicad_sch, sensor-hub.kicad_pcb]
2025-05-10 Most layout done
    [mcu.kicad_sch, sensor-hub.kicad_pcb, sensor-hub.kicad_sch]
2025-05-17 DRC fixes
    [mcu.kicad_sch, sensor-hub.kicad_pcb]
2025-05-17 Finalize layout
    [power.kicad_sch, sensor-hub.kicad_pcb, sensors.kicad_sch]
2025-05-18 V1.0
    Fixed value typos, replaced vias with 0.3/0.45, added production files
    [mcu.kicad_sch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]
2026-02-08 Add LVGL screen driver
2026-02-15 Cleanup, remove redundant prints
2026-02-23 Temporary PCAL driver
2026-03-09 Encoder driver
2026-03-09 Fix encoder readout
2026-03-09 PWM LCD backlight
2026-03-12 Refactor LCD driver
2026-05-12 Add i2c driver to support later irq driven approach
2026-05-15 Update to newer firmware pack
    Bump SPI to ~6mb/s
