Aifryz/sensor-hub/(notices)

Notices in the files:
firmware/stm32/Core/Inc/main.h:
Copyright (c) 2025 STMicroelectronics.
All rights reserved.
hardware/sensor-hub/sensor-hub.kicad_pcb:
Licensed under CERN-OHL-P v2 or later
